AndreiCiuhu/Fundamental-Electronic-Circuits---Project-Audio-frequency-amplifier-3rd-year-project/Proiect docs/Documentatie.pdf

## UNIVERSITATEA NAȚIONALĂ de ȘTIINȚĂ și TEHNOLOGIE POLITEHNICA BUCUREŞTI

Facultatea de Electronică, Telecomunicaţii şi Tehnologia Informaţiei

## Circuite electronice fundamentale 2 - Proiect

## Amplificator de tensiune (joasă frecvență)

## Ciuhureanu Andrei

## Grupa 431D

### București 2024

## Date inițiale de proiectare: N=9

Să se proiecteze și realizeze un amplificator de tensiune (joasă frecvență)

### având următoarele caracteristici:

¨ Semnal de intrare, ui in gama: 540 [mV];

¨ Sarcina la ieșire, RL: 90 [Ω];

¨ Rezistența de intrare Ri >150 [kΩ];

¨ Rezistența de ieșire Ro < 0,9 [Ω];

¨ Amplificare în tensiune, Av: 10;

¨ Domeniul temperaturilor de funcționare: 0°-70°C (verificabil prin testare în temperatură);

¨ Semnalizarea prezenței tensiunilor de alimentare cu diodă de tip LED.

INTRODUCERE:

### Amplificatorul de tensiune este un circuit care are rolul de a furniza la ieșirea sa o tensiune proporțională cu cea de la intrare. Relația de bază este:

### Vout = Av ∙ Vin

¨ Vout este tensiunea de ieșire amplificatorului.

¨ Vin este tensiunea de intrare a amplificatorului.

¨ Av este amplificarea de tensiune a amplificatorului, mărime adimensională.

În practică, este destul de dificil de respectat relația de bază, întrucât amplificarea Av nu este o mărime constantă. Din acest motiv, amplificatoarele de precizie se realizează cu o reacție negativă puternică. Pentru îndeplinirea acestei cerințe, se utilizează un amplificator (diferențial) cu două intrări: una inversoare și cealaltă neinversoare. Acesta amplifică, de fapt, diferența tensiunilor de pe cele două intrări. La intrarea neinversoare se aplică semnalul de de intrare Vin, iar pe cealaltă

intrare, o fracțiune (fv) din cel de pe ieșirea circuitului Vf = fv ∙ Vout.

### Amplificarea globală a circuitului este: Av =

av
1+fv∙av

=

av
1+T

### , unde av reprezintă

### amplificarea în buclă deschisă, iar T este transmisia pe buclă (T>0, pentru o reacție

negativă ( |Av| < |a| ) ).

### Dacă av ≫ 1 => T ≫ 1, atunci amplificarea cu reacție devine: Av ≅

1
fv

### Ca urmare, amplificarea Av nu mai depinde de structura amplificatorului de bază AB, ci numai de elementele din circuitul reţelei de reacţie, deci uşor de controlat şi

bine definite.

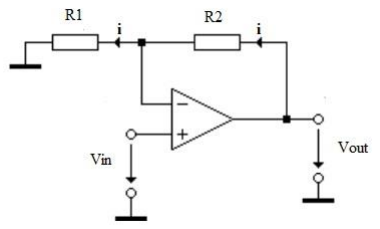
[picture p11: figure]

### În acest caz: fv =

R1
R1+R2

=> Av ≅

1
fv

= 1 +

R2
R1

=

Vout
Vin

### (= 10, conform cerinței

### noastre), deci alegem R2

R1

≅ 9.

SCHEMA BLOC A AMPLIFICATORULUI:

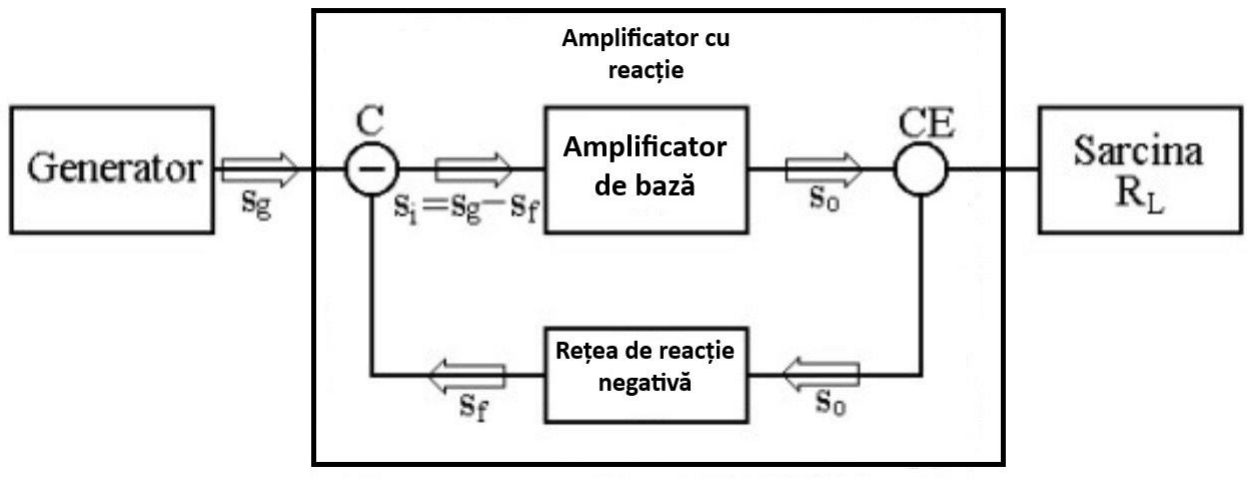
[picture p12: figure]

SCHEMA ELECTRICĂ A AMPLIFICATORULUI:

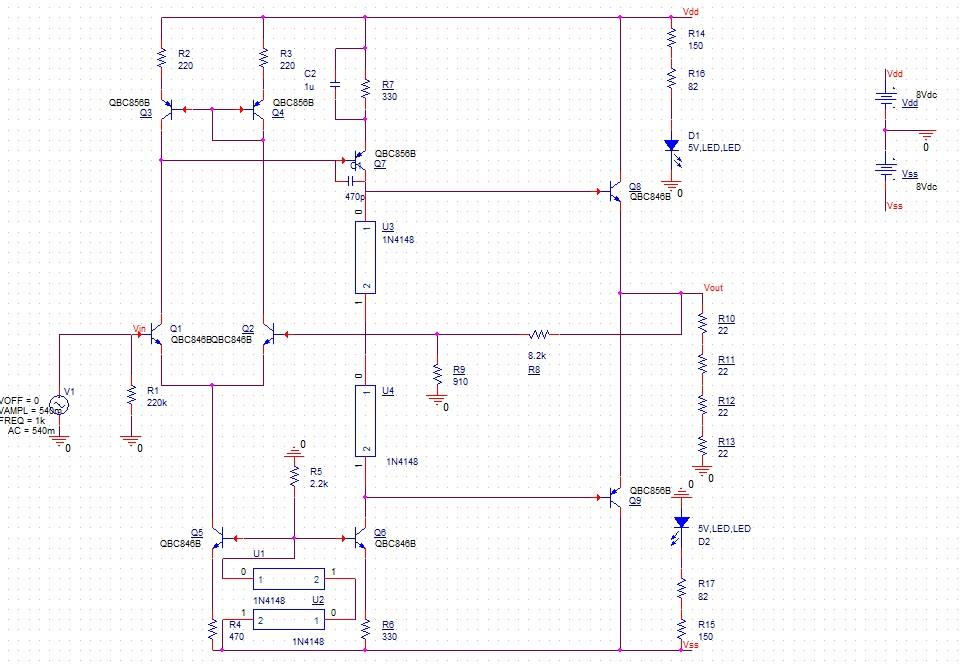
[picture p13: figure]

La intrarea circuitului se observă etajul diferențial, alcătuit din tranzistoarele bipolare NPN Q1 și Q2. Acesta este alimentat de sursa de curent(Q5), al cărei curent este dat de relația: Ic5 =

2Vd−Vbe5
R4

. Deasupra diferențialului se află o oglindă de curent, alcătuită din 2 tranzistoare PNP identice (Q3 și Q4). Aceasta asigură că cei doi curenți de colectori ai tranzistoarelor Q1 și Q2 sunt egali, pentru eficiență.

Următorul etaj este cel de amplificare cu tranzistorul bipolar PNP(Q7) în conexiune emitor-comun. Acesta primește curent de la sursa de curent(Q6).

Relația acestuia este: Ic6 =

2Vd−Vbe6
R6

Condensatorul de compensare C1(470pF) asigură stabilitatea sporită a circuitului, modificând semnificativ banda de frecvență (Efectul Miller). Condensatorul de capacitate mai mare C2(1µF) are rolul de a deveni scurtcircuit în modelul de curent alternativ al circuitului; astfel, prin rezistența R7 nu va trece niciun curent alternativ datorită impedanței foarte mici a condensatorului.

Etajul de ieșire în clasă AB, configurație push-pull, este alcătuit din tranzistoarele Q8(NPN) și Q9(PNP) și generatorul BIAS, format din diodele D3 și D4, ce prepolarizează cele două tranzistoare.

Toate diodele cu jonctiuni p-n funcționează în regim de conducție, curenții prin ele fiind dați de relațiile:

ID1 = ID2 =

Vss−2VD
R5

și ID3 = ID4 ≅ Ic6, VD ≅ 0.6V

Diodele LED lucrează în conducție, curenții având următoarele relații:

Iled1 = Iled2 =

Vdd−Vled
R14+R16

, Vled ≅ 3V.

Rețeaua de reacție negativă este de tip serie-paralel și este alcătuită din rezistențele R8 și R9. Pentru satisfacerea cerinței am ales valorile rezistențelor R8 = 8.2kΩ și R9 = 910Ω.

Av ≅

1
fv

= 1 +

R8
R9

≅ 1 + 9.01 = 10.01

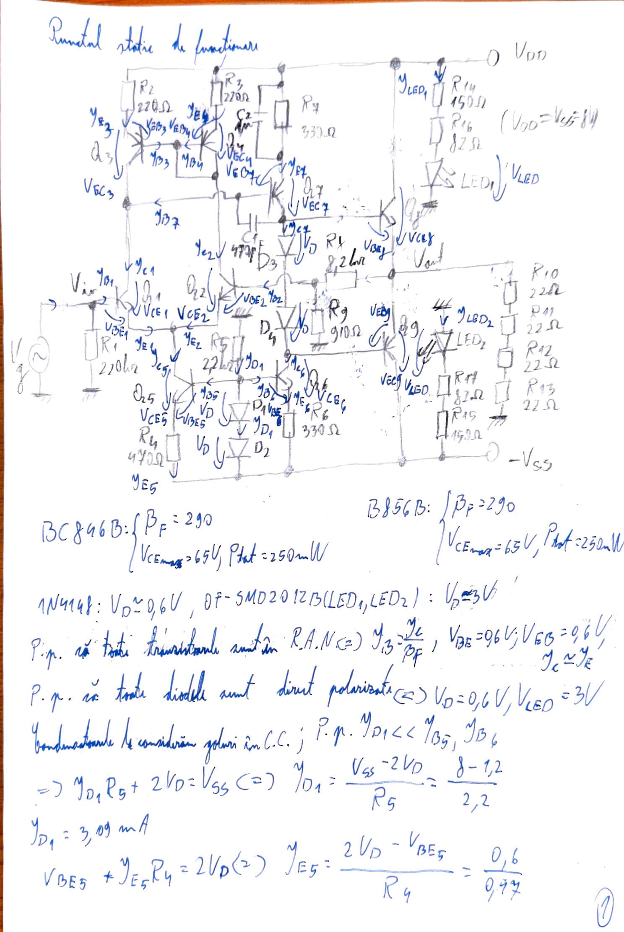
[picture p14: page 6]
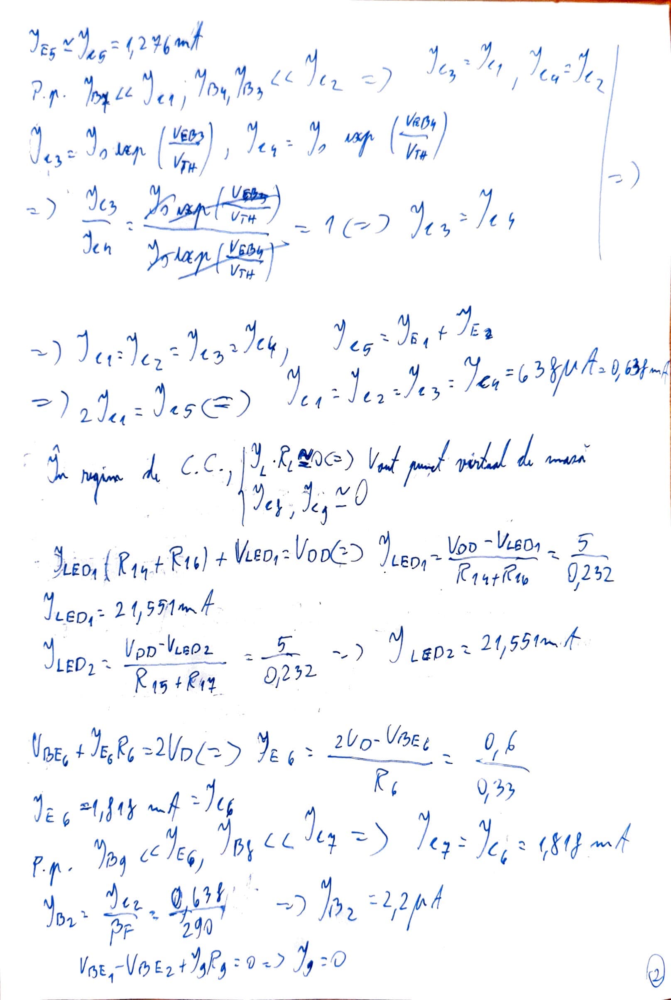
[picture p15: page 7]
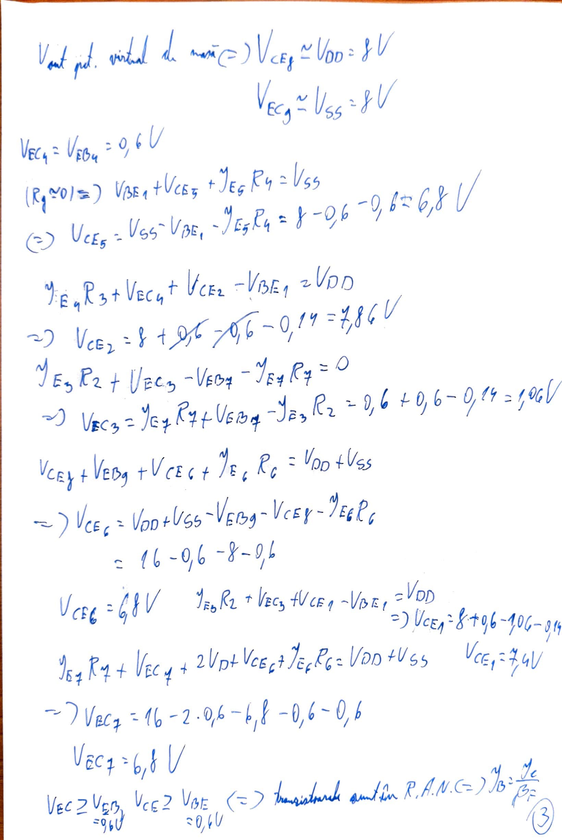
[picture p16: page 8]

j E
1

# r:; t Ve.c i, t l!ch -v,,£ 1 -z, V.o 0

# ~) V - e ..1 r.v( - /r - O I '1 -:: 'l-1! tf/

CG J-. - 1 -, 7J 'P | 7 v1 ~ | I

# j £4.) f 1.. + Ui;c") -v~(',1 -1f,, h :: ⁰

# """) Vi c"J-:. J~ 1.f + f-VG &

# 1 -j;,.., R-i. .,_ D1 C I- 0 b - ~ tr == ~ fJt; (I

# V c £} f- If E C>1 t Va Cf j t , f c : tloo + (J SJ

# ...,,__ ) Va, "" i/00 1-V~? -VF.01- V c q · -1 Ed c

# -: 1, -01fo -l-~l

# Ver, : ~ a V 1,J1. 1- he~ -f(/ CF. 1 -Vf}r' '.C VoD

## ~) (/C£1: f·t 0

1

# ' -1. 01 I v- 8 ff

# 1o 1 r 1 + v~c i -t 2 /; pl- Vcs ,1 l:,fc: VDD {-(/ ~ s Va=,: f w I I

--I V ec r -- 1 b - 2 · rork - ~ f -O b - 0 6 I | I | I

# Vcq ~f) [/

Vee 2 V;;I}} lier 2 VM;. (-;c) ~ p.)t,.,_ ?,//.;fl.C-:.) /8!-/;; "~ w | :: o , IJ | r ', 2.l

I

'0

# ~ 1 : pf f t O ( ( if 25 ,._ w)

# ~(; p KL':. 1~; f'l '.. J~ ,~ 11W{ { (lf"'-(;1.;)

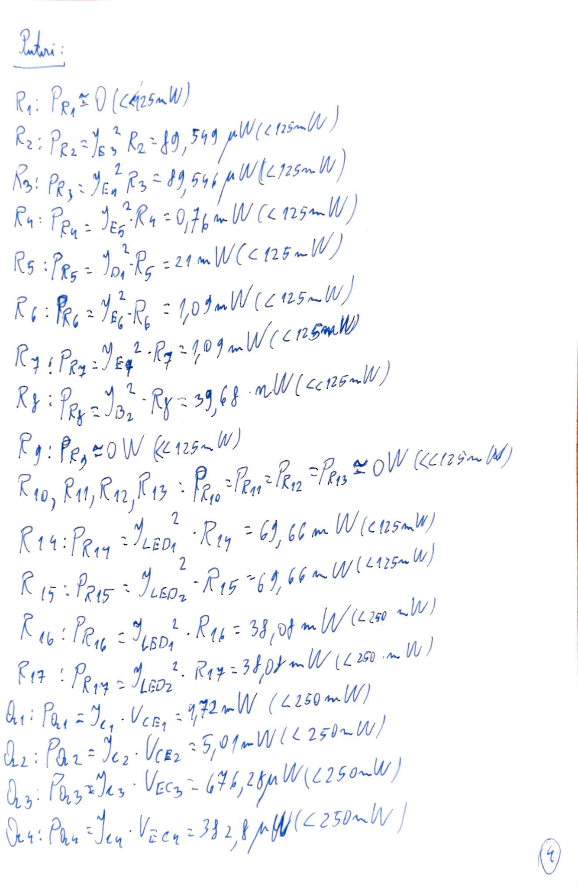
[picture p17: page 9]

## 7 I

# x,,_, • Pt>..__ y r, }1,:.. Jj ,i, 11 wt L/15= l!1J)

r: Pi | fl | / ~' f:11 : jf.? .f ~ : OJ1 f, n-.. W ( l125"-W)

## /( S :ff, :. j D11._ ff : l 1 ,.,._ w ( C {2 ; ,._ /j(/)

## r ~ : PR, .,. 1 G~ -R~ : 11 o 1 t,,. w rt {2-f - w)

# re "1 { 0 - 114 - 2. • R .,__ 4 (ii 111--Wr oz§~JYI

# 1 . I K1, - J Ef 1 t

# ?. } ; r R1r C. ) 0~ -ro -:: :;'JC s '«v/Jfl { Cc ,2v,..W)

# fr f r

# 1 -:ow f.L 1zf, w J

? 10

1

R 11/

12

/n ·

# . fr,/fr1

# i'-fe12 -:(j,/1! o IJ!I (<.azf- W)

# f t ti : ff 1'1 : jLED: . Rr1 :. C j/ b C""' w (I'. (27,.._W)

# R { '] ·. pi? ff ..__ J L EtJ ~ -Rf f --b 1; U "'- W { L

11
,,.., W)

# f n : f 1?

1

# , : 1uo/ . R 1¹, : ;J 1 'D? ,,,.. (A/CL 2,0 ... /Ill J

f 11 '. !}
11

## -;. Yuo/ -r711 :. 3 i/ f - WI L 2&0 _,.._ IJ1J)

# &1 : fo.. 1 ; '.lti . Vcr,1 :. 1/1~W ( u to-W)

# IL; fa 1-: )t 2

# . Vci,. ~ '!i/t,,..W r l u·o'L.. w)

~ :ii . Po,, 7 k ')l ., · Vi:c '.? -:_ t i I/ tt W ( {2 § o .... W)

# Ut~ '.Pei,,, ~ J<t · V.: e, ~ JJ 1}/tiJ( L zso,.,__/Jv I

0

# Q 5 ¹ p ~~- " J,c ,;- ' Vct'i -::.. Ji 1 ""' IA/ ( c uo ... ();)

# Q 4 1 (9,,, : :JI~ · Va_ (: 121 ~, 11-.. Wru.ru,...UJ)

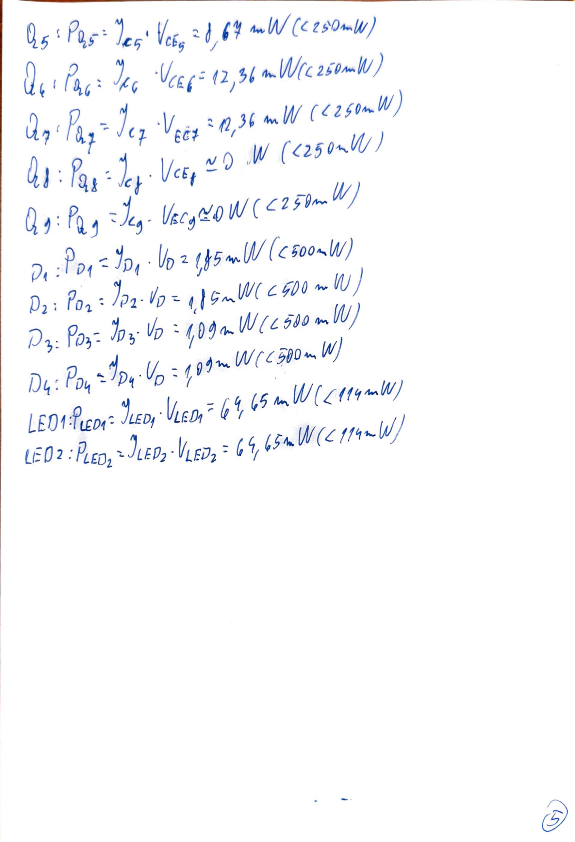
[picture p18: page 10]

Q 7 I Po,.1 ";. J ( 7 . V . ~ (} 3' 4¥. w ( u f o .... w) l | r | f tJ'j | I a J . 00 • 1 Ver IV O "W' ( a 5 o ...... W) . I 4 ! - Jc J, . | cf -

# a 1 : p Q j -J.~

# , . (/4c ~ r! .{) I)} ( C Z f 9,.,_ /JI)

# Vi :f 01 -:.101 · lfv 2 ti' ,..._ {,A/ (uoo ... W)

# /Ji : Pa'l : Jpz · !lo""'" d r;,,,._ /J//( c. fJO ,.,.,. //1) )

7J
17

# : Po~: lo,· ilo : f' o ~,-,...//ti ( t. iJo fl,,, W)

D~ '. Po~ .,_1P1 ·Vo : io' ..... wrc_§Oo-.... w)

### L£01 :P !£Of~ lw, · ~£'°1 ;: G ~( ,, ,i.,. /;{/ ( ,( w,,,_w)

L/; 0 2 : Pt.mi -Ju/Ji -l!uvz = C \ ,; ..... W ( c /1'1"- [j/)

. -·
