AndreiCiuhu/Fundamental-Electronic-Circuits---Project-Audio-frequency-amplifier-3rd-year-project/Simulations/ac_sweep.jpg

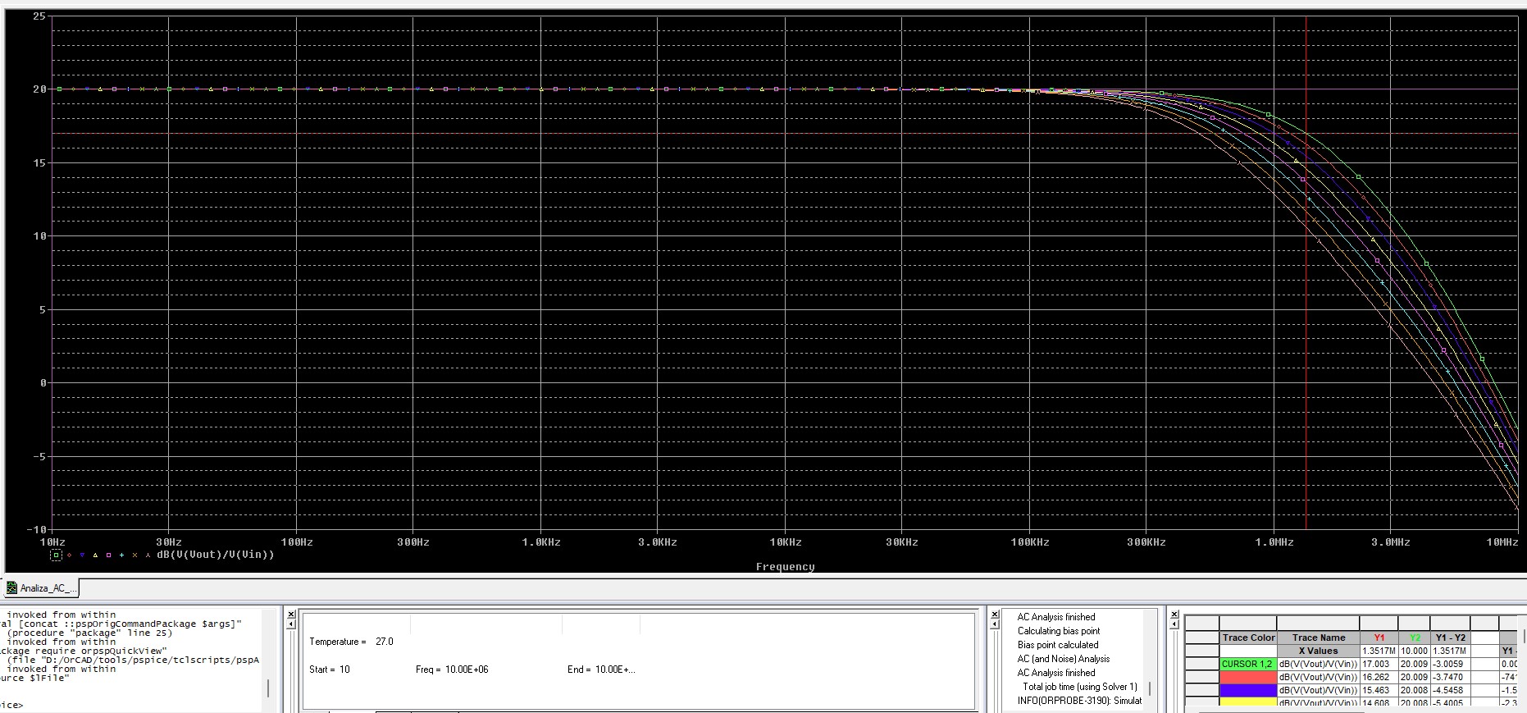
Simulations/ac_sweep.jpg
