AndreiCiuhu/Fundamental-Electronic-Circuits---Project-Audio-frequency-amplifier-3rd-year-project/Simulations/Crossover(1).jpg

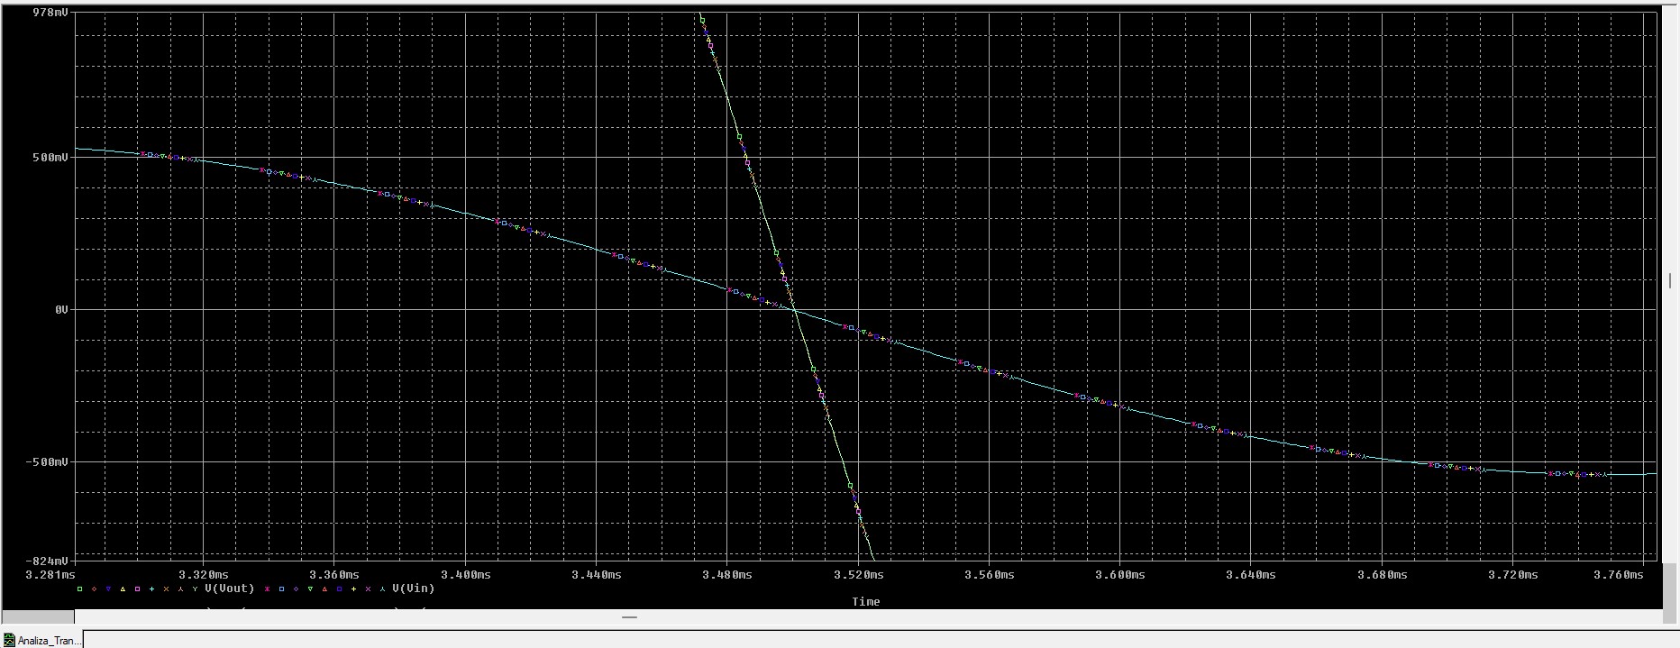
Simulations/Crossover(1).jpg
