AndreiCiuhu/Fundamental-Electronic-Circuits---Project-Audio-frequency-amplifier-3rd-year-project/Simulations/Crossover(2).jpg

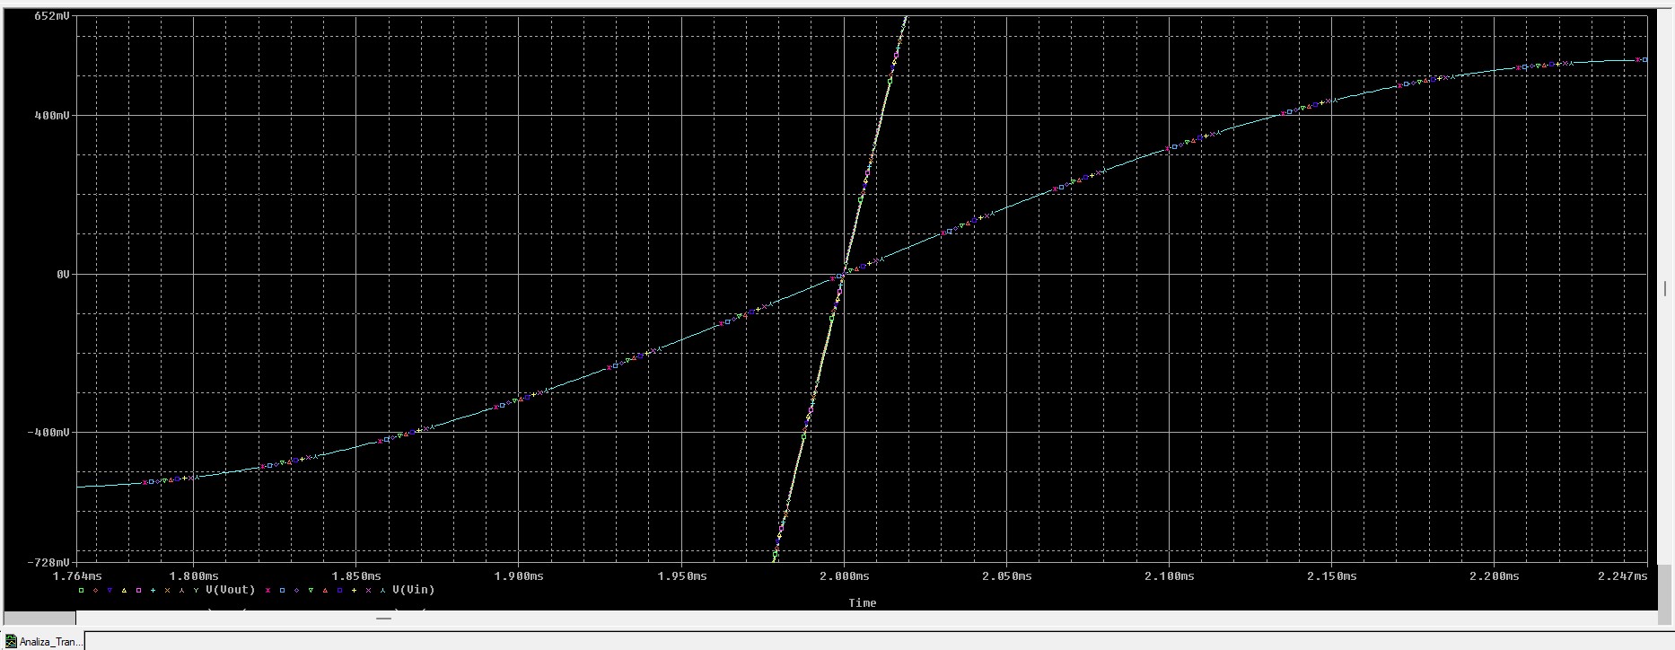
Simulations/Crossover(2).jpg
