AndreiCiuhu/Fundamental-Electronic-Circuits---Project-Audio-frequency-amplifier-3rd-year-project/Simulations/dc_sweep.jpg

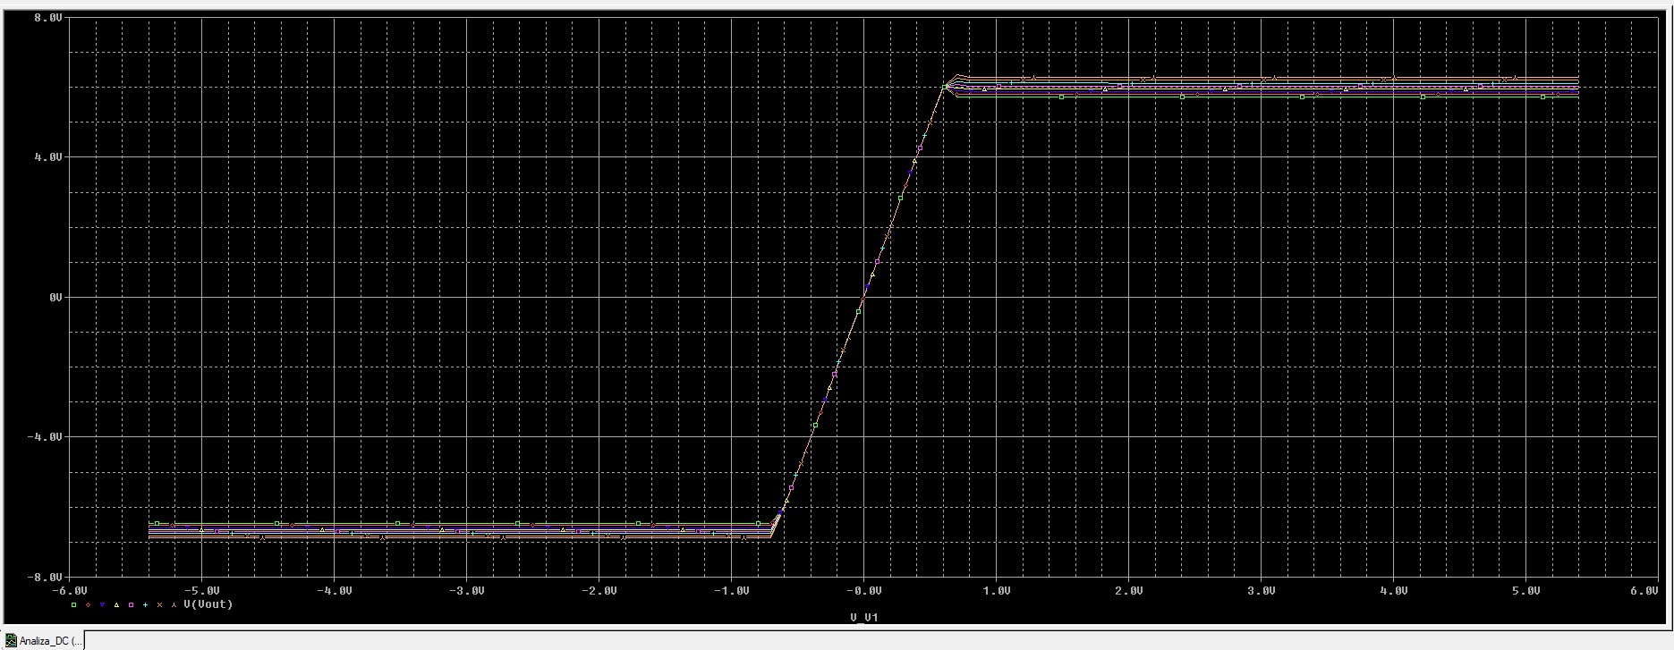
Simulations/dc_sweep.jpg
