AndreiCiuhu/Fundamental-Electronic-Circuits---Project-Audio-frequency-amplifier-3rd-year-project/Simulations/puteri_DC.jpg

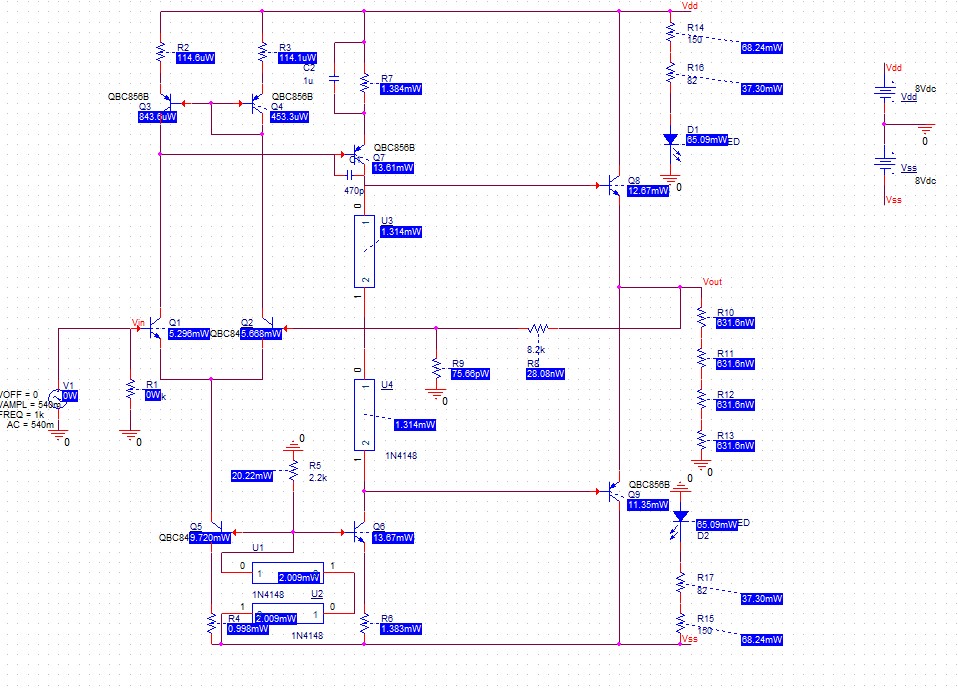
Simulations/puteri_DC.jpg
