AndreiCiuhu/Fundamental-Electronic-Circuits---Project-Audio-frequency-amplifier-3rd-year-project/Simulations/rezistenta de iesire.jpg

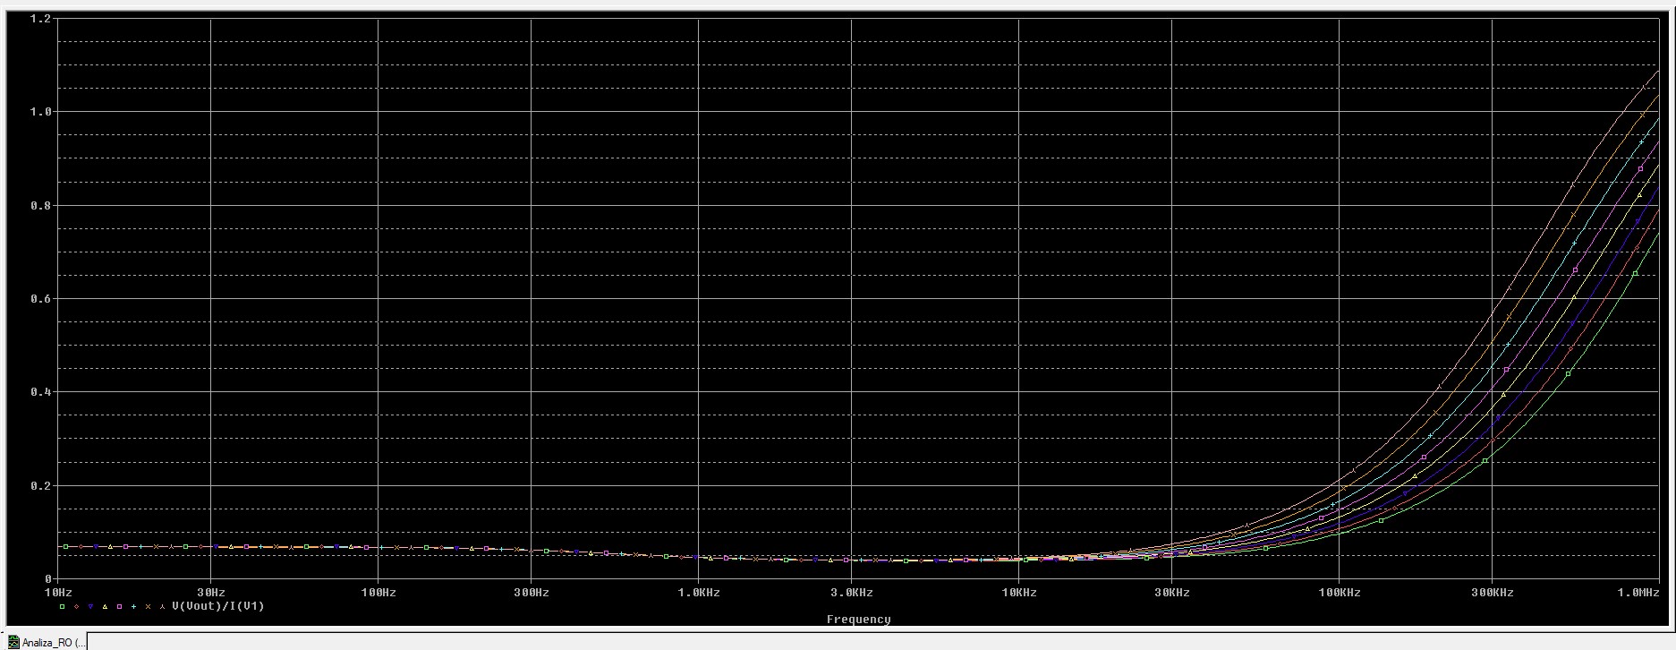
Simulations/rezistenta de iesire.jpg
