AndreiCiuhu/Fundamental-Electronic-Circuits---Project-Audio-frequency-amplifier-3rd-year-project/Simulations/rezistenta de intrare.jpg

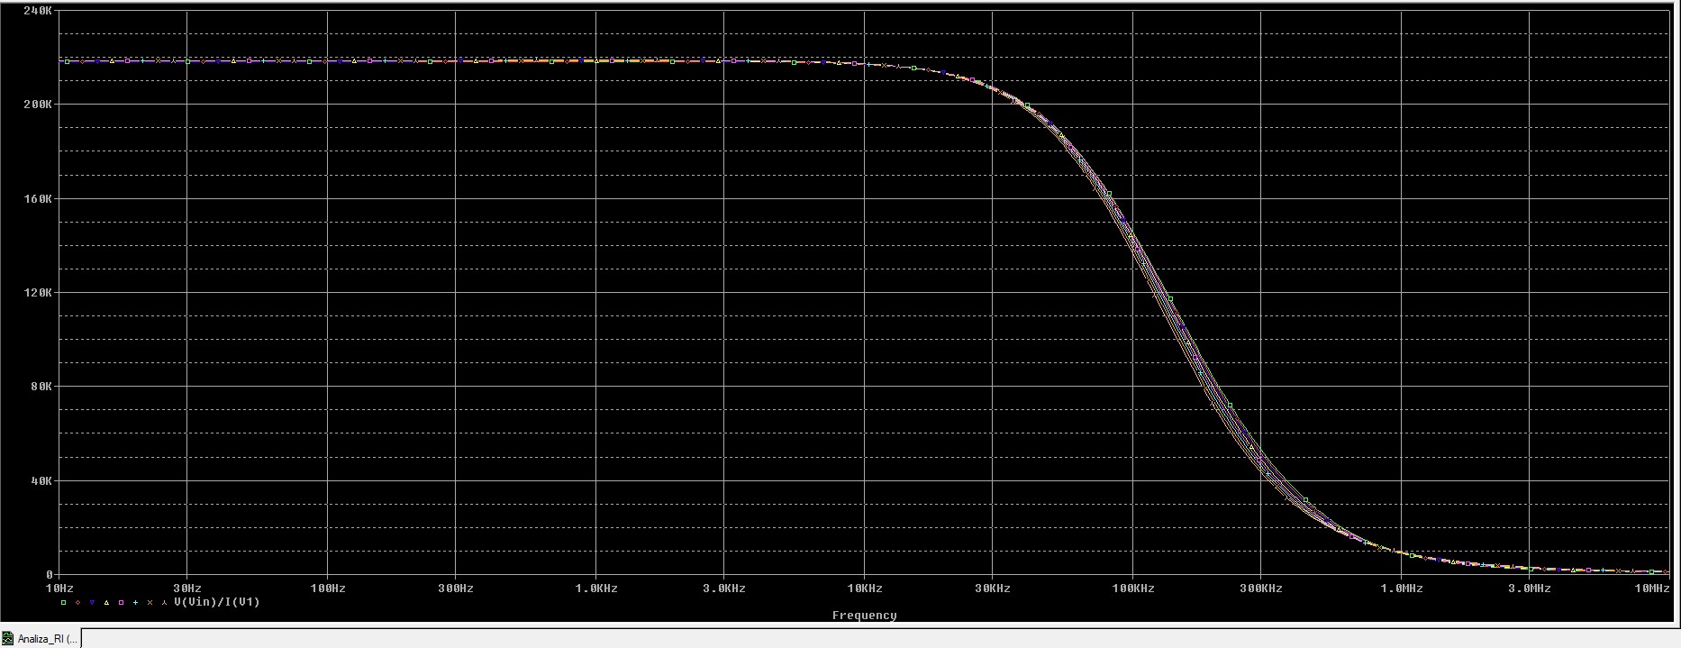
Simulations/rezistenta de intrare.jpg
