AndreiCiuhu/Fundamental-Electronic-Circuits---Project-Audio-frequency-amplifier-3rd-year-project/Simulations/stabilitatea.jpg

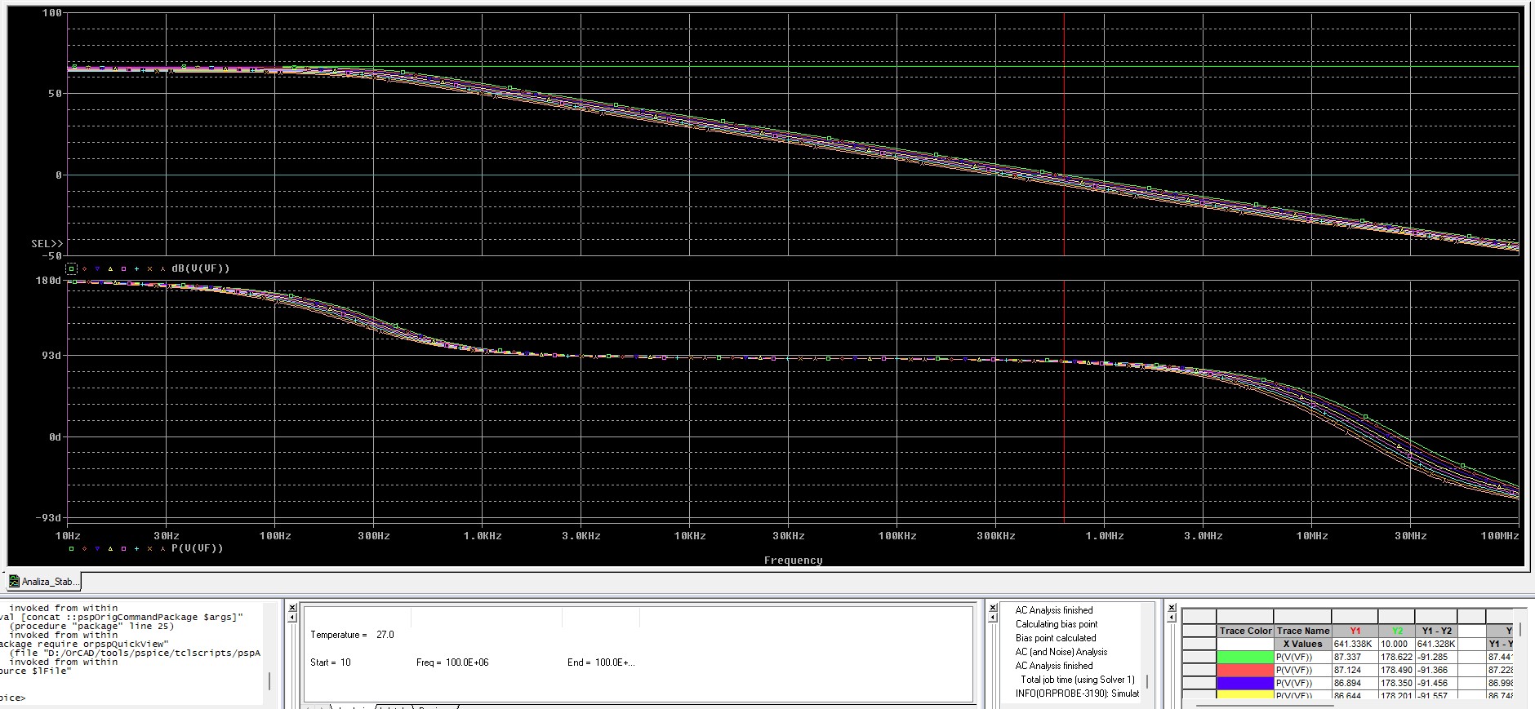
Simulations/stabilitatea.jpg
