AndreiCiuhu/Fundamental-Electronic-Circuits---Project-Audio-frequency-amplifier-3rd-year-project/(list of files, drawings)

Other design files:
Schematics/SCHEMA_BLOC.DSN
Schematics/schema_bloc.opj
